MitchellThies/8-button-controller/(commit log)

2020-04-10 Added code and library
    First version of the code made to work with my 49 LED array with the FastLED library.
2020-04-11 Update audioMatrix.ino
    Added extra modes and fixed a hardcode issue in the cylon function.
    [audioMatrix.ino]
