MitchellThies/8-button-controller/img/comp2.jpg

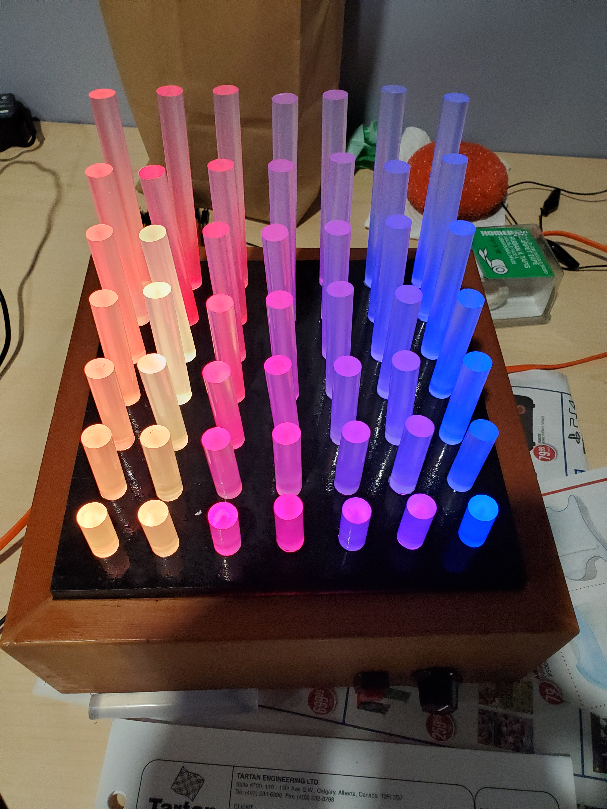
[picture p2: img/comp2.jpg]
img/comp2.jpg
