MitchellThies/8-button-controller/img/plastic.jpg

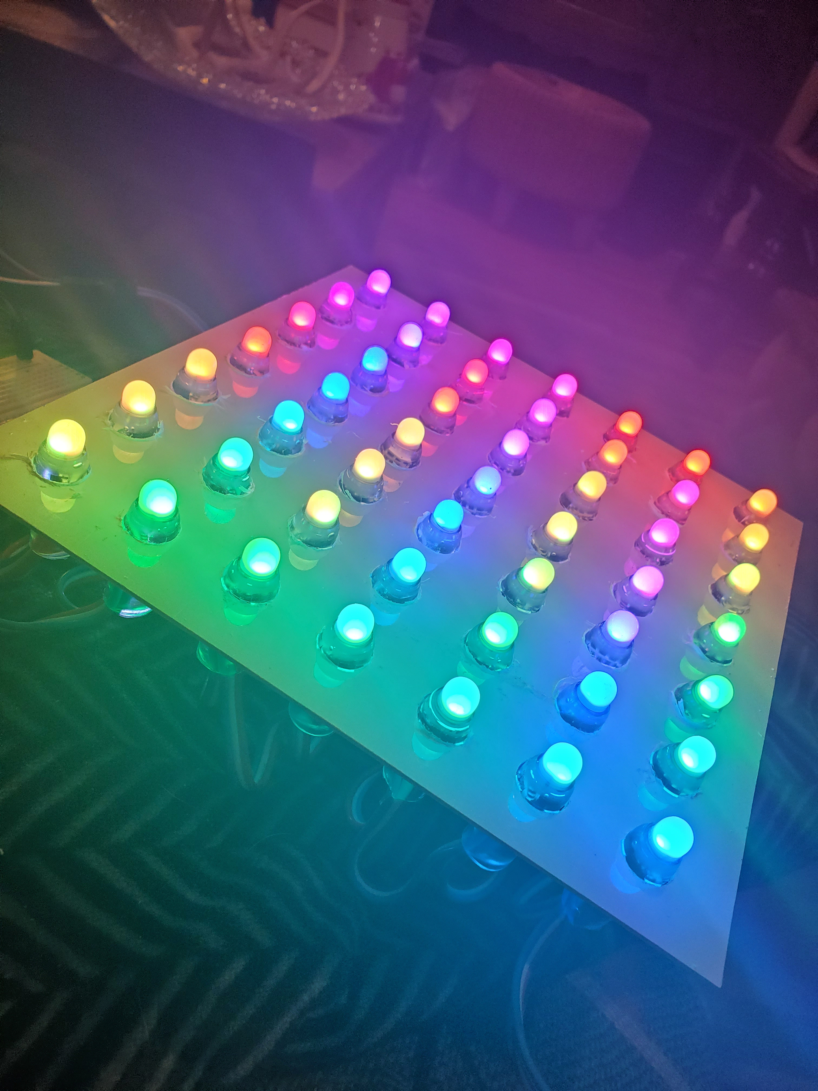
[picture p4: img/plastic.jpg]
img/plastic.jpg
